hazmatjunk/EquatorialMount/README.md

# EquatorialMount
Musings and designs for telescope mounts

This is just a place to store idears for telescopes
