hazmatjunk/EquatorialMount/Updated Component designs/stepperMount.stl

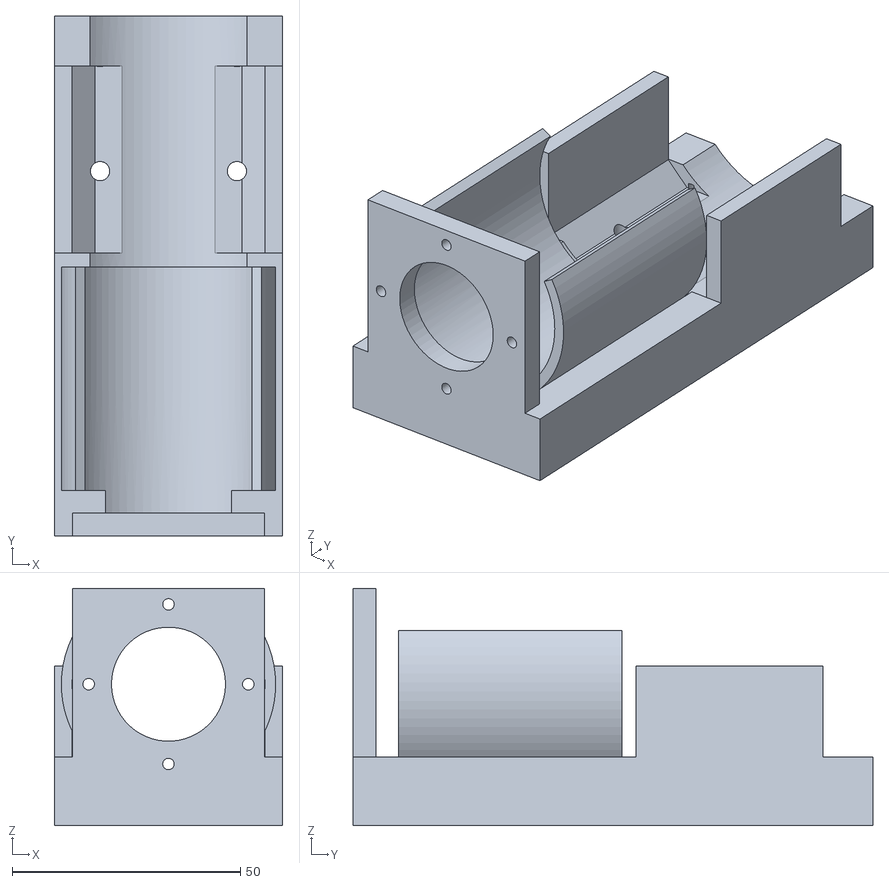
[picture p2: CAD file, 2021-11-07]
Updated Component designs/stepperMount.stl
50.0 x 114.0 x 52.0
