hazmatjunk/EquatorialMount/Updated Component designs/eqMountPreciseparts  assembled v8.png

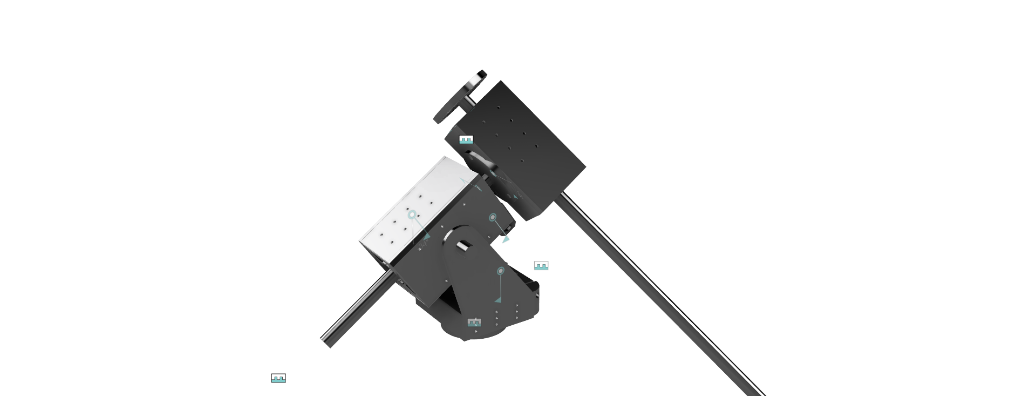
Updated Component designs/eqMountPreciseparts assembled v8.png
