hazmatjunk/EquatorialMount/Updated Component designs/Axel Pin Drawing v1.pdf

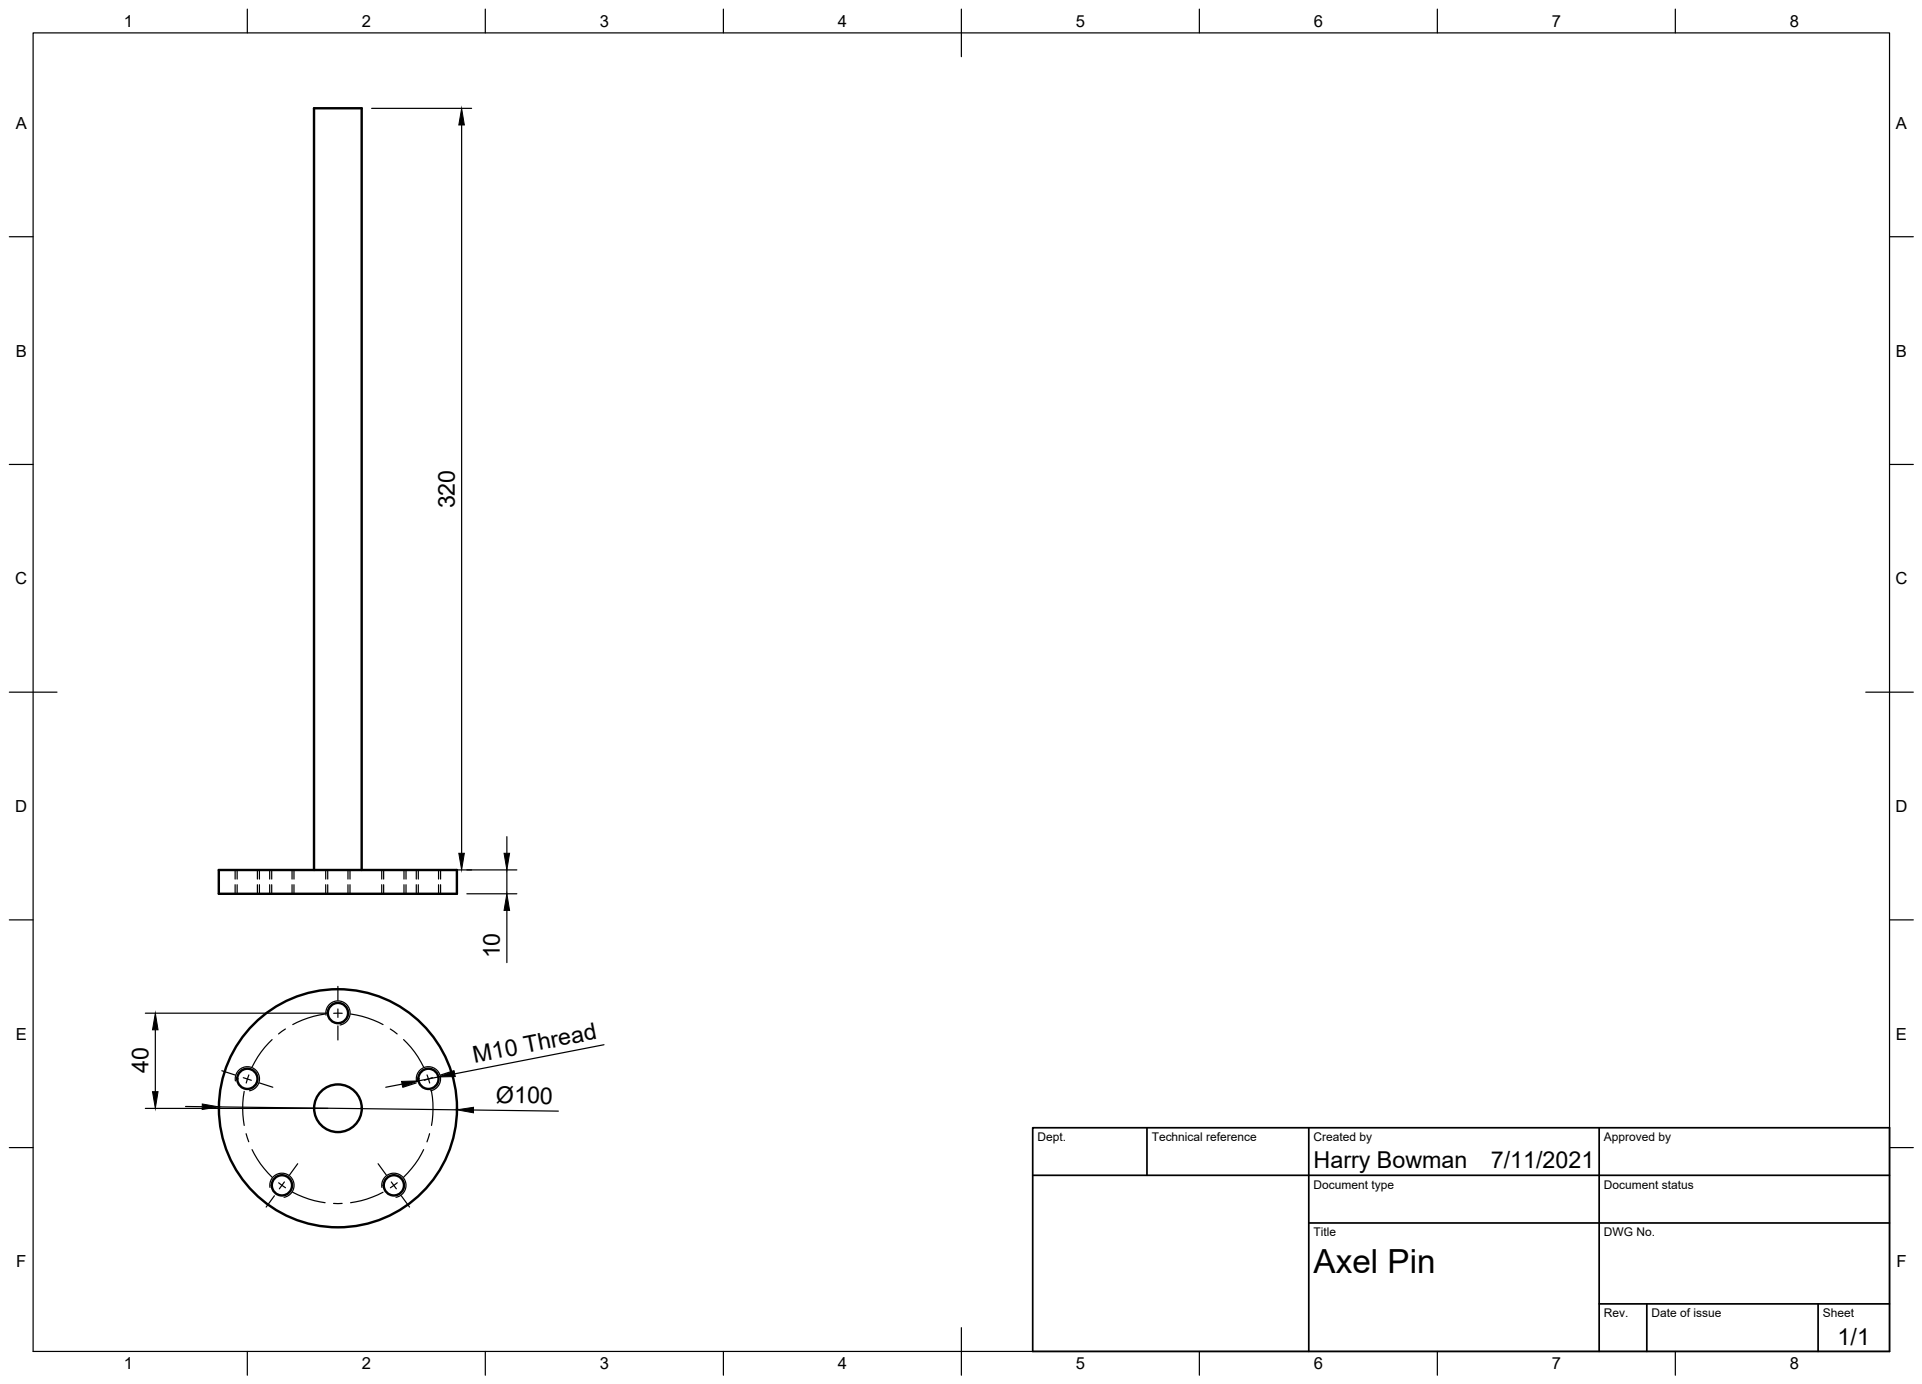
[picture p4: page 1]
Title; DWG No.; Rev.; Date of issue; Sheet; Axel Pin; Harry Bowman 320; M10 Thread

Dept. | Technical reference | Created by 7/11/2021 | Approved by

Document type | Document status
