hazmatjunk/EquatorialMount/Updated Component designs/base housing Plate Drawing v1.pdf

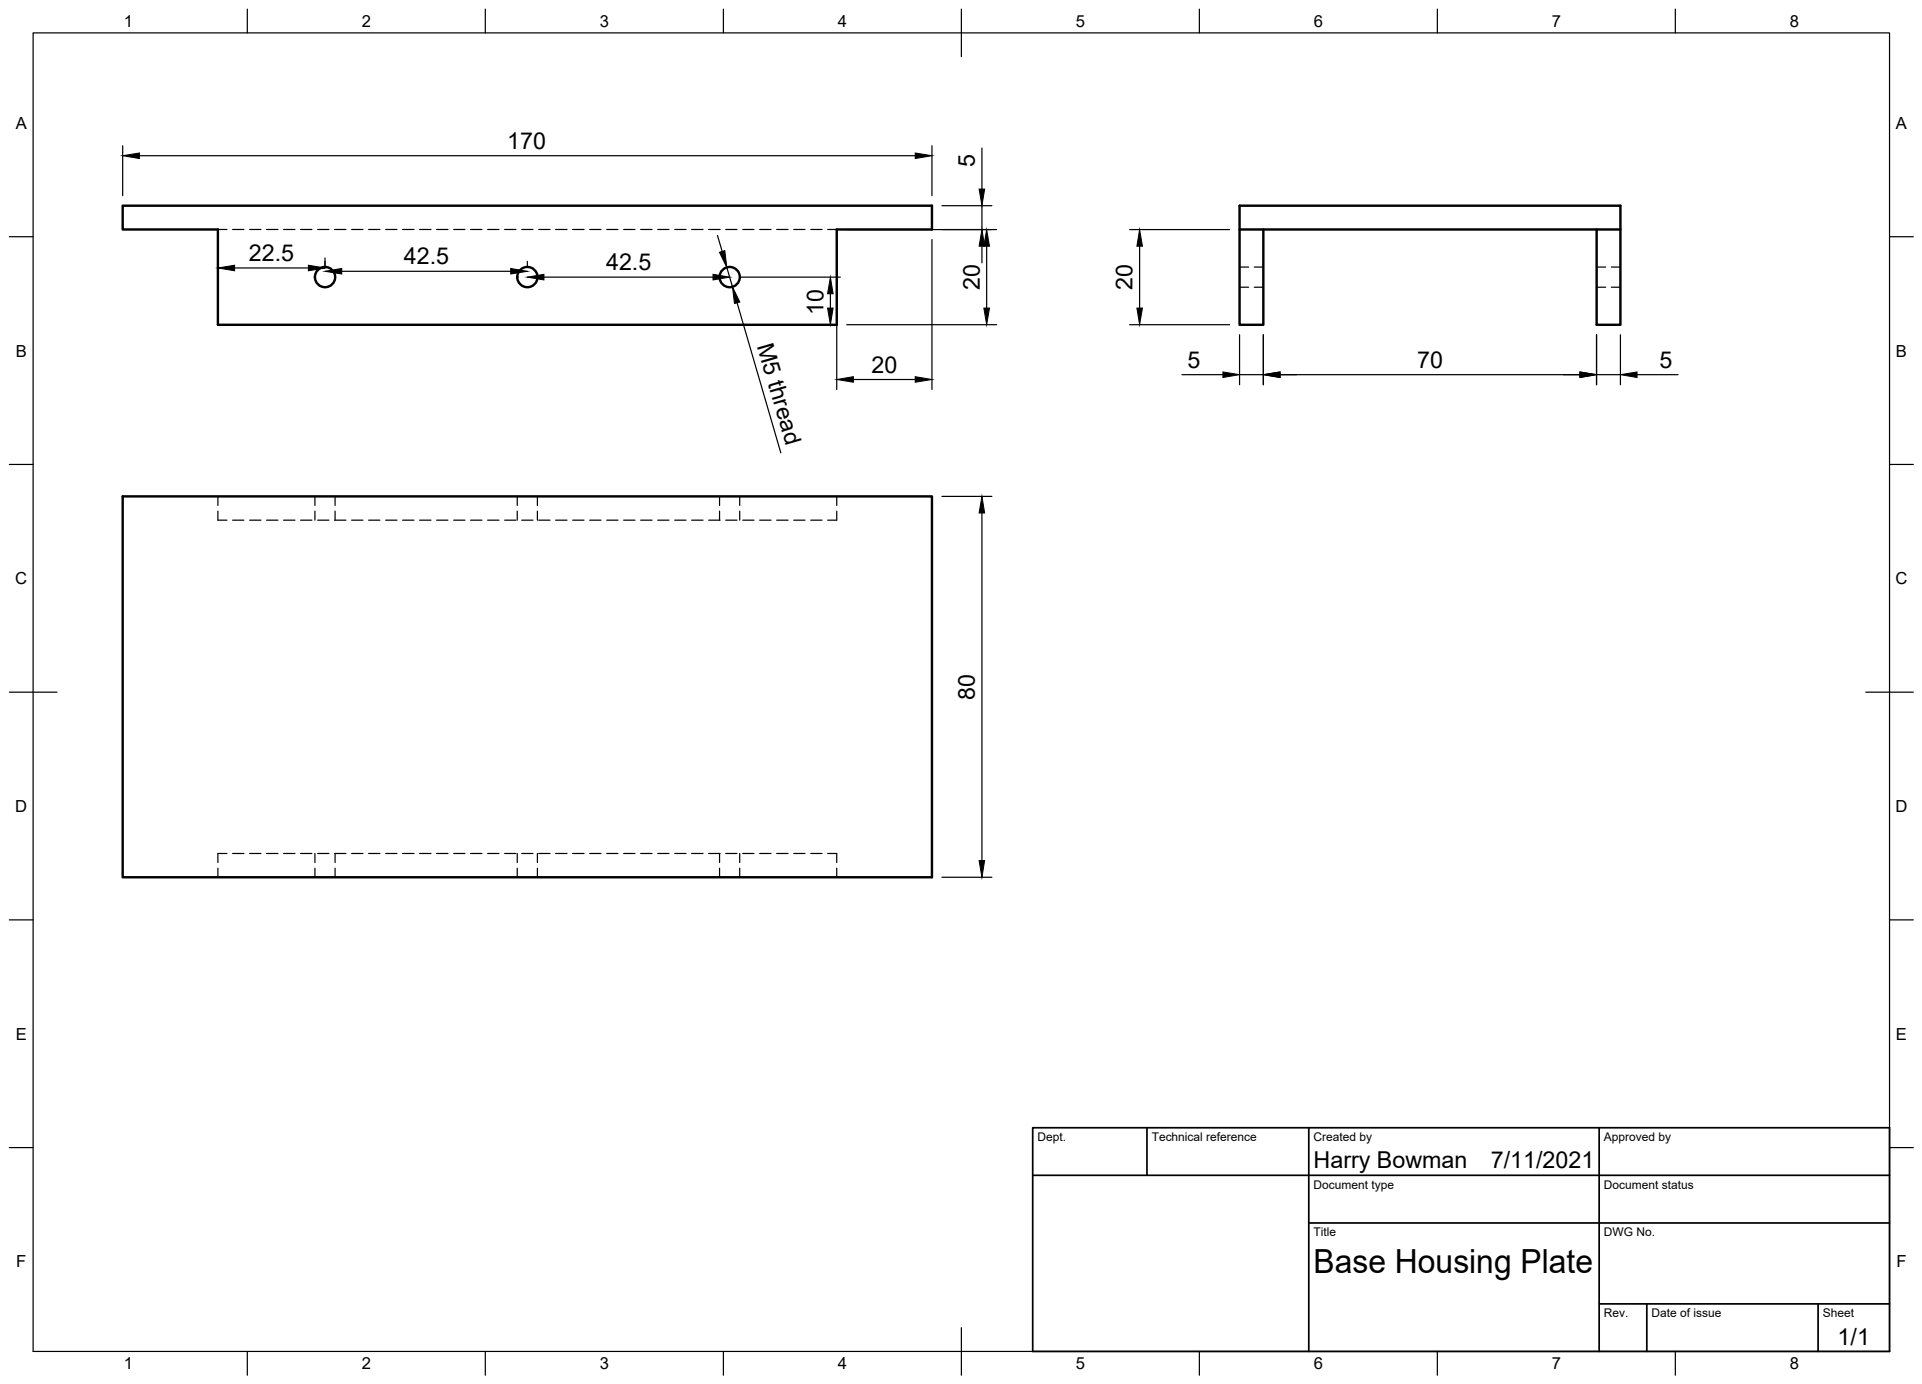
[picture p5: page 1]
Title; DWG No.; Rev.; Date of issue; Sheet; M5 thread

Dept. | Technical reference | Created by Harry Bowman 7/11/2021 | Approved by

Document type | Document status

Base Housing Plate
