hazmatjunk/EquatorialMount/Updated Component designs/basePlate Drawing v2.pdf

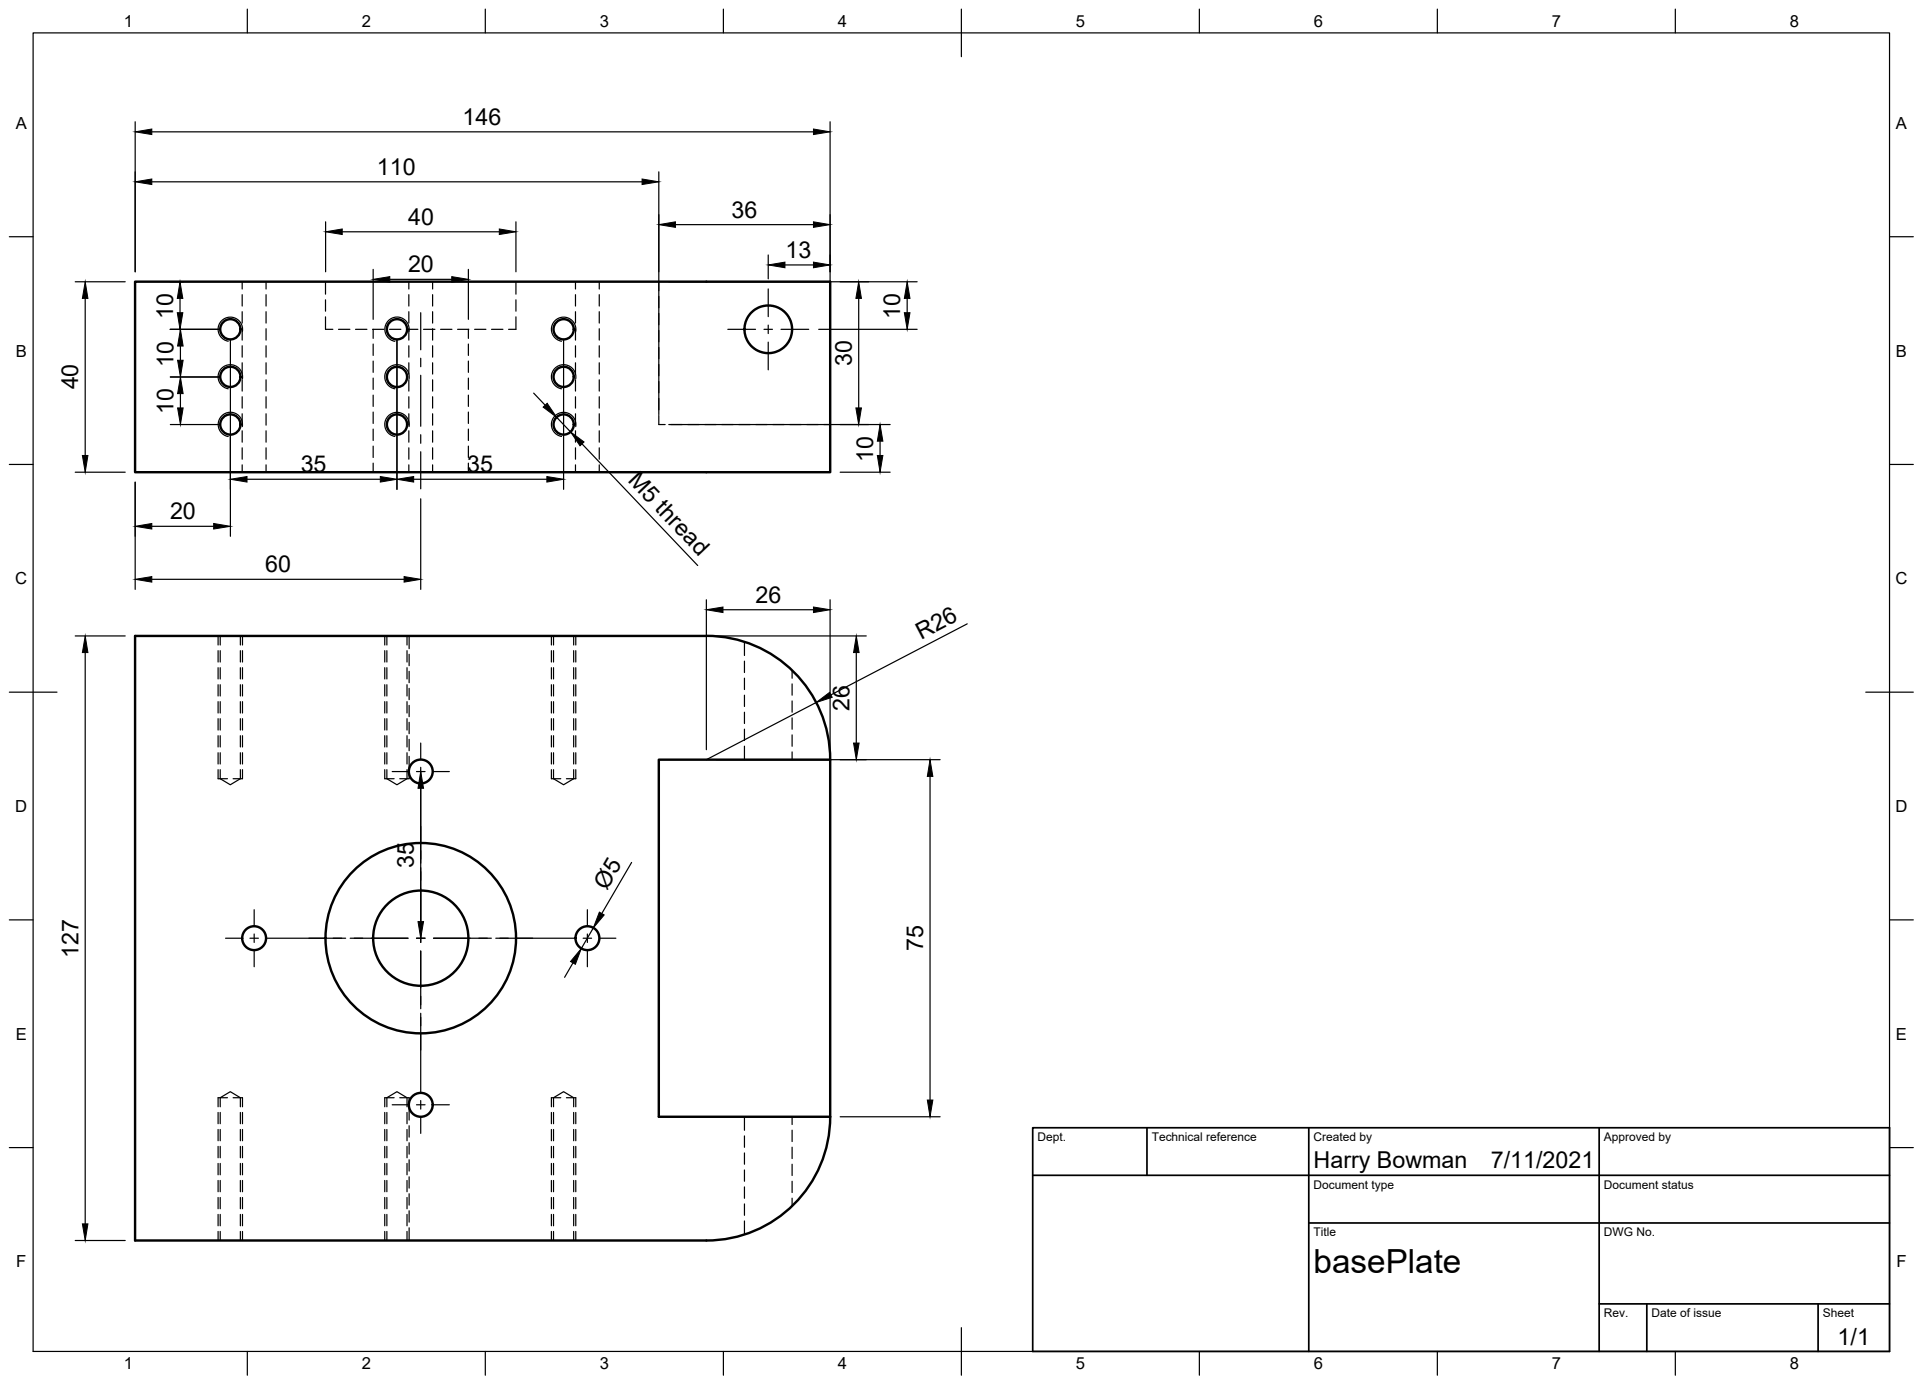
[picture p6: page 1]
Title; DWG No.; Rev.; Date of issue; Sheet; Harry Bowman 40; M5 thread

Dept. | Technical reference | Created by 7/11/2021 | Approved by

Document type | Document status
