hazmatjunk/EquatorialMount/Updated Component designs/Dec Pin Plate Drawing v2.pdf

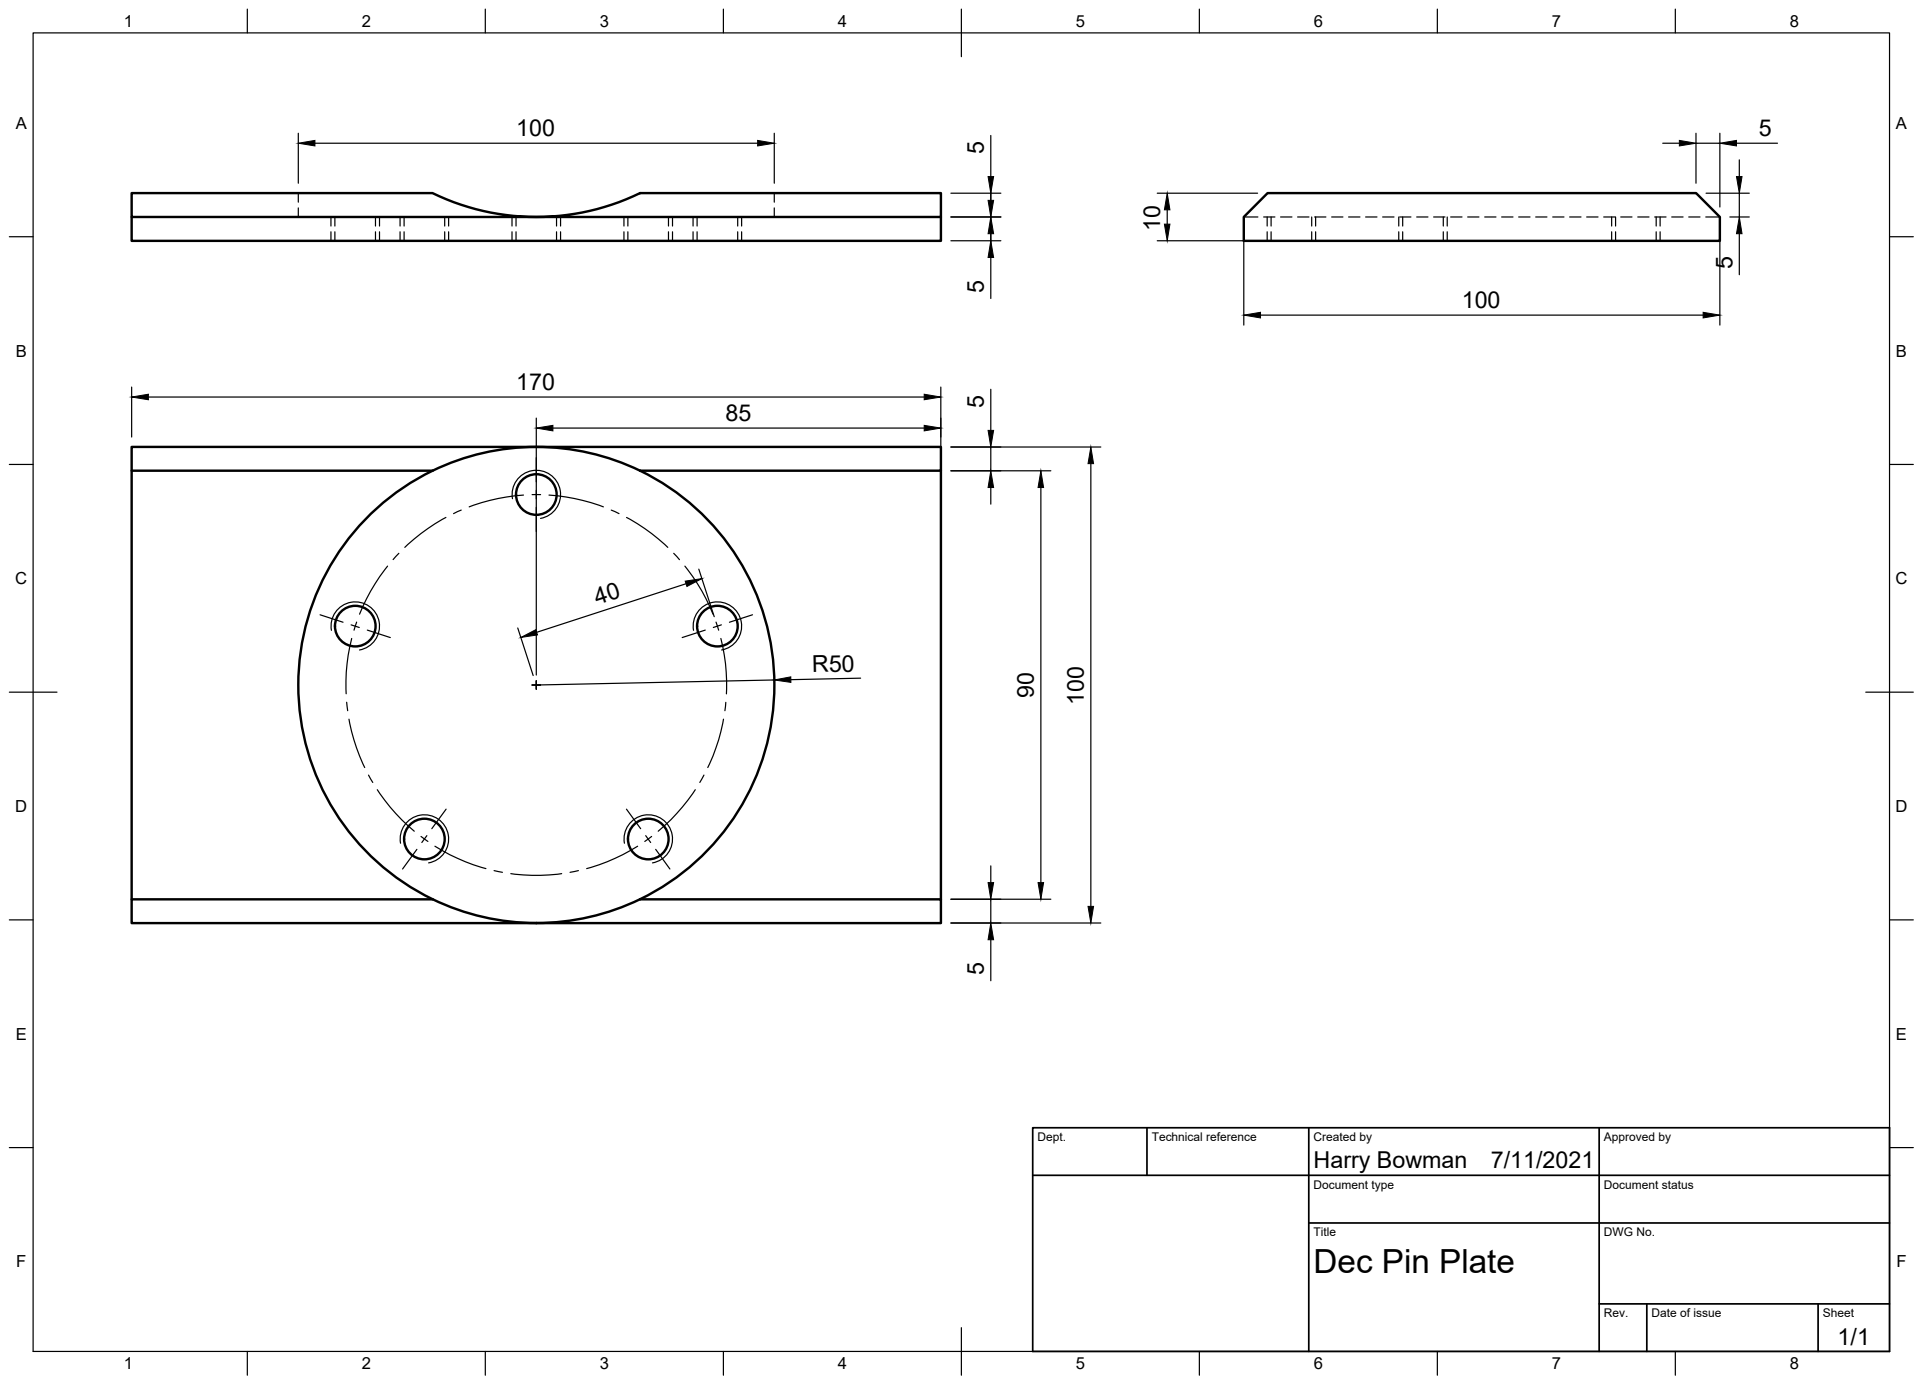
[picture p7: page 1]
Title; DWG No.; Rev.; Date of issue; Sheet

Dept. | Technical reference | Created by Harry Bowman 7/11/2021 | Approved by

Document type | Document status

Dec Pin Plate
