hazmatjunk/EquatorialMount/Updated Component designs/End Plates Drawings v1.pdf

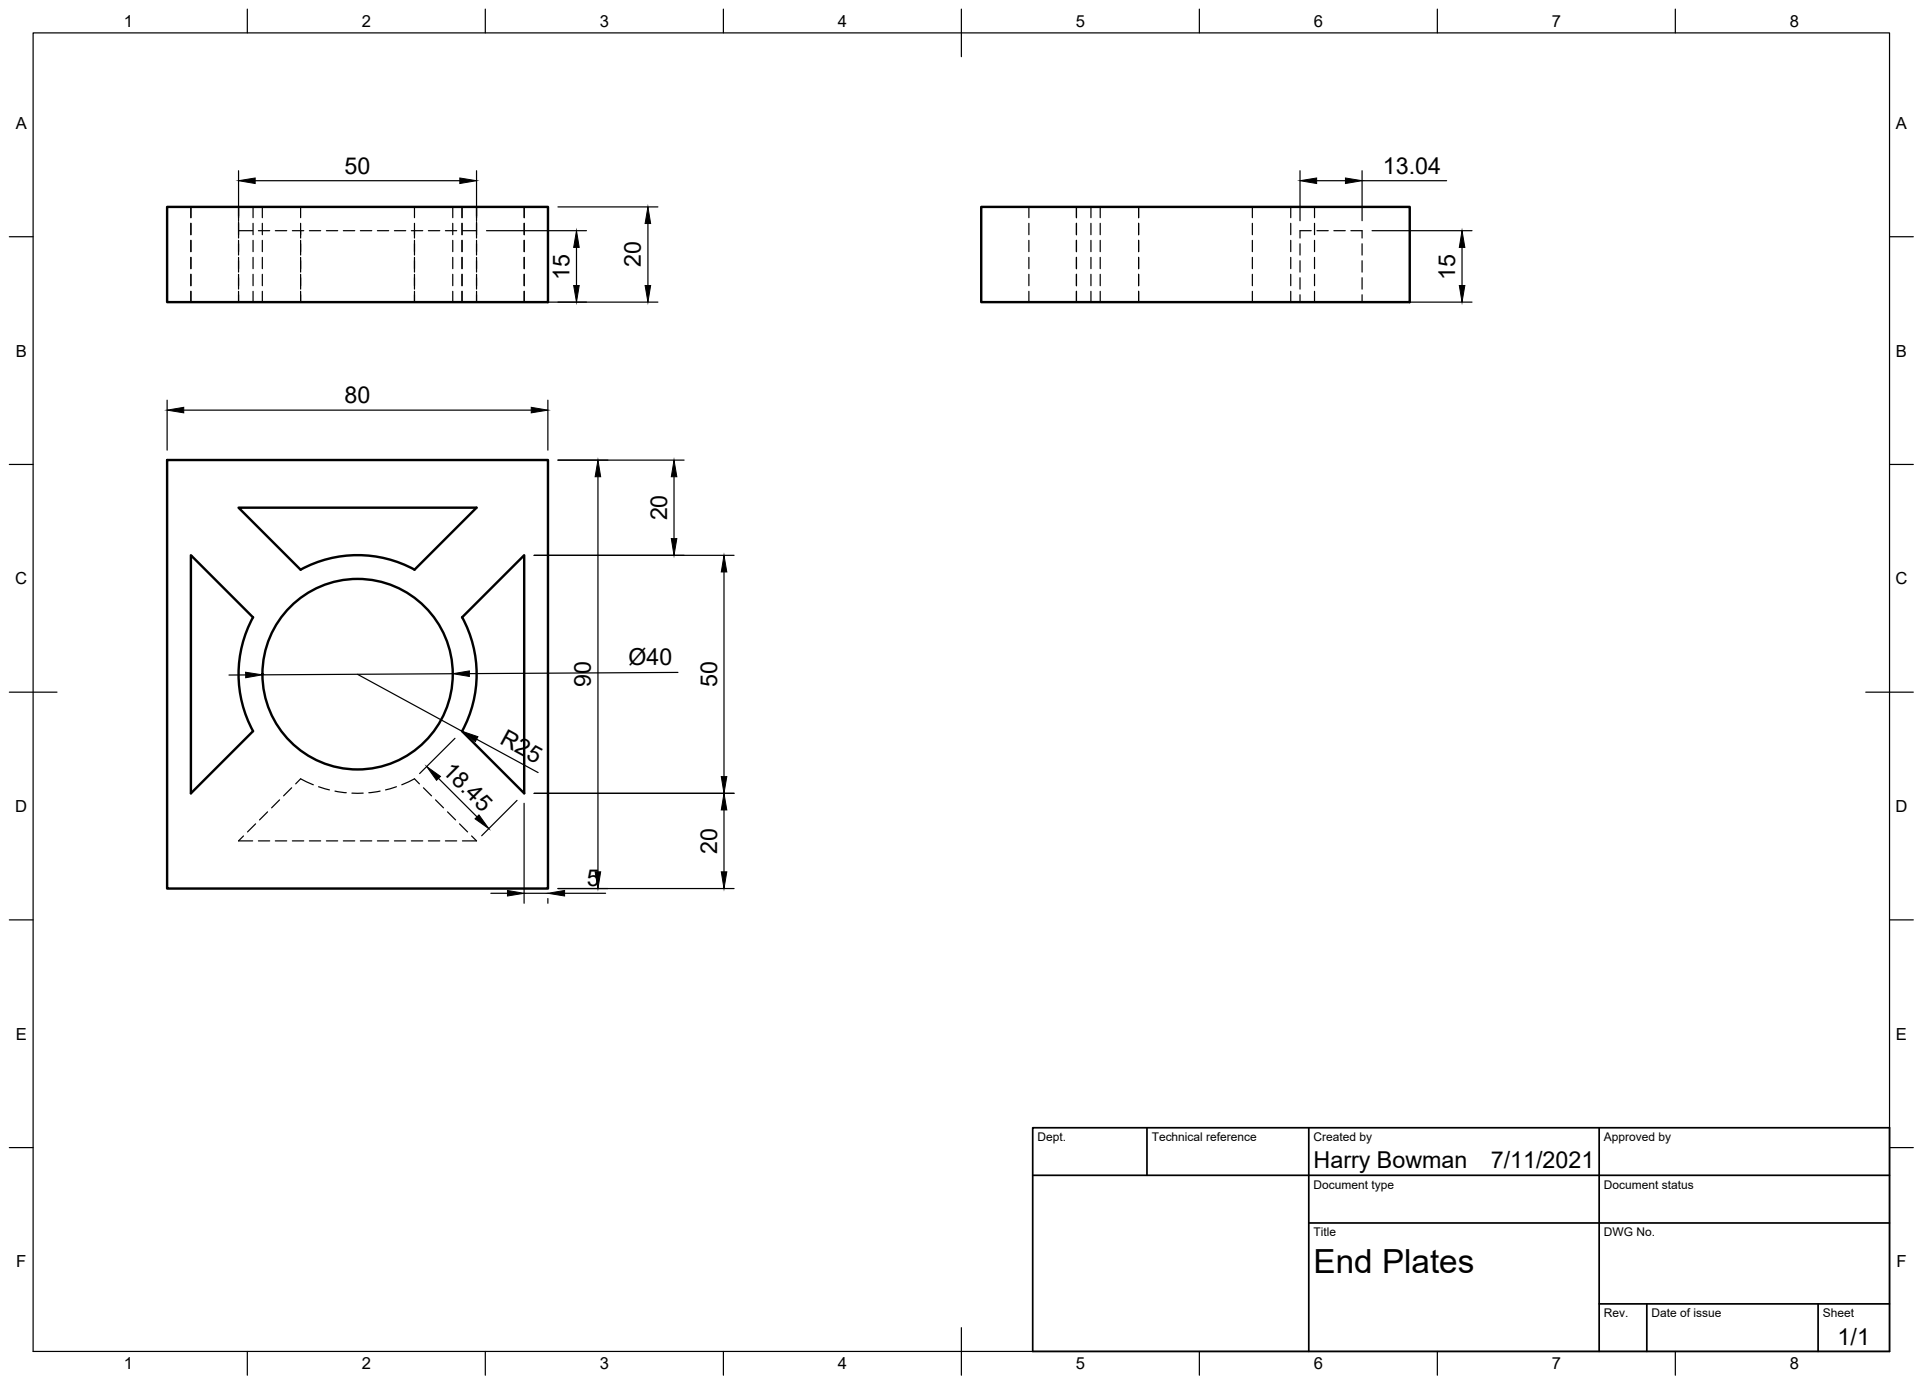
[picture p8: page 1]
Title; DWG No.; Rev.; Date of issue; Sheet; End Plates

Dept. | Technical reference | Created by Harry Bowman 7/11/2021 | Approved by

Document type | Document status
