hazmatjunk/EquatorialMount/Updated Component designs/RA Clapm Drawing v1.pdf

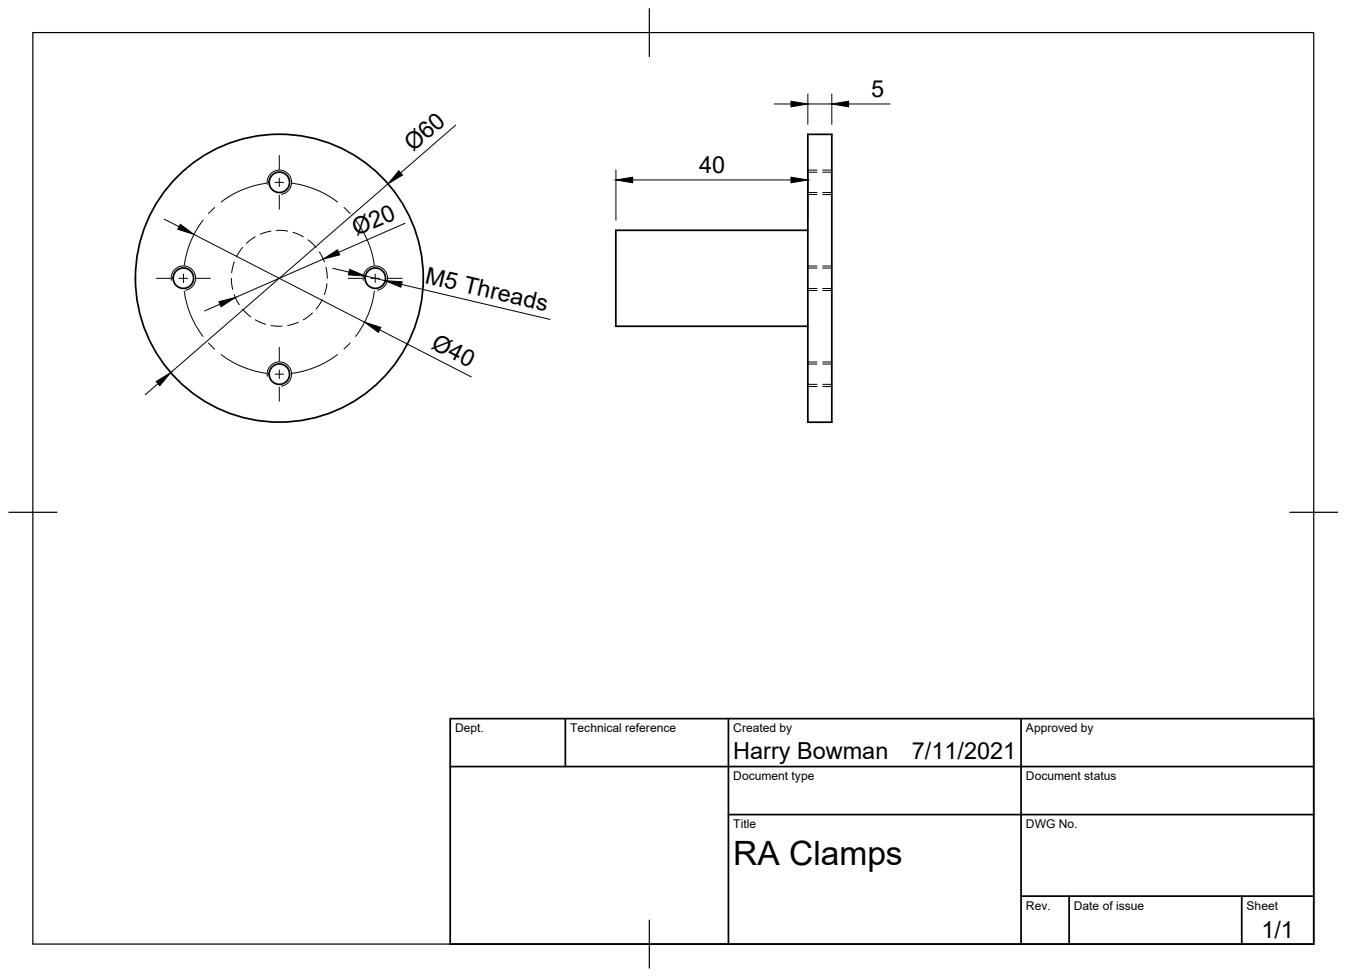
[picture p9: page 1]
M5 Threads

Dept. | Technical reference | Created by Harry Bowman 7/11/2021 | Approved by

Document type | Document status

Title RA Clamps | DWG No.

Rev. | Date of issue | Sheet 1/1
