hazmatjunk/EquatorialMount/Updated Component designs/Side Plate v2.pdf

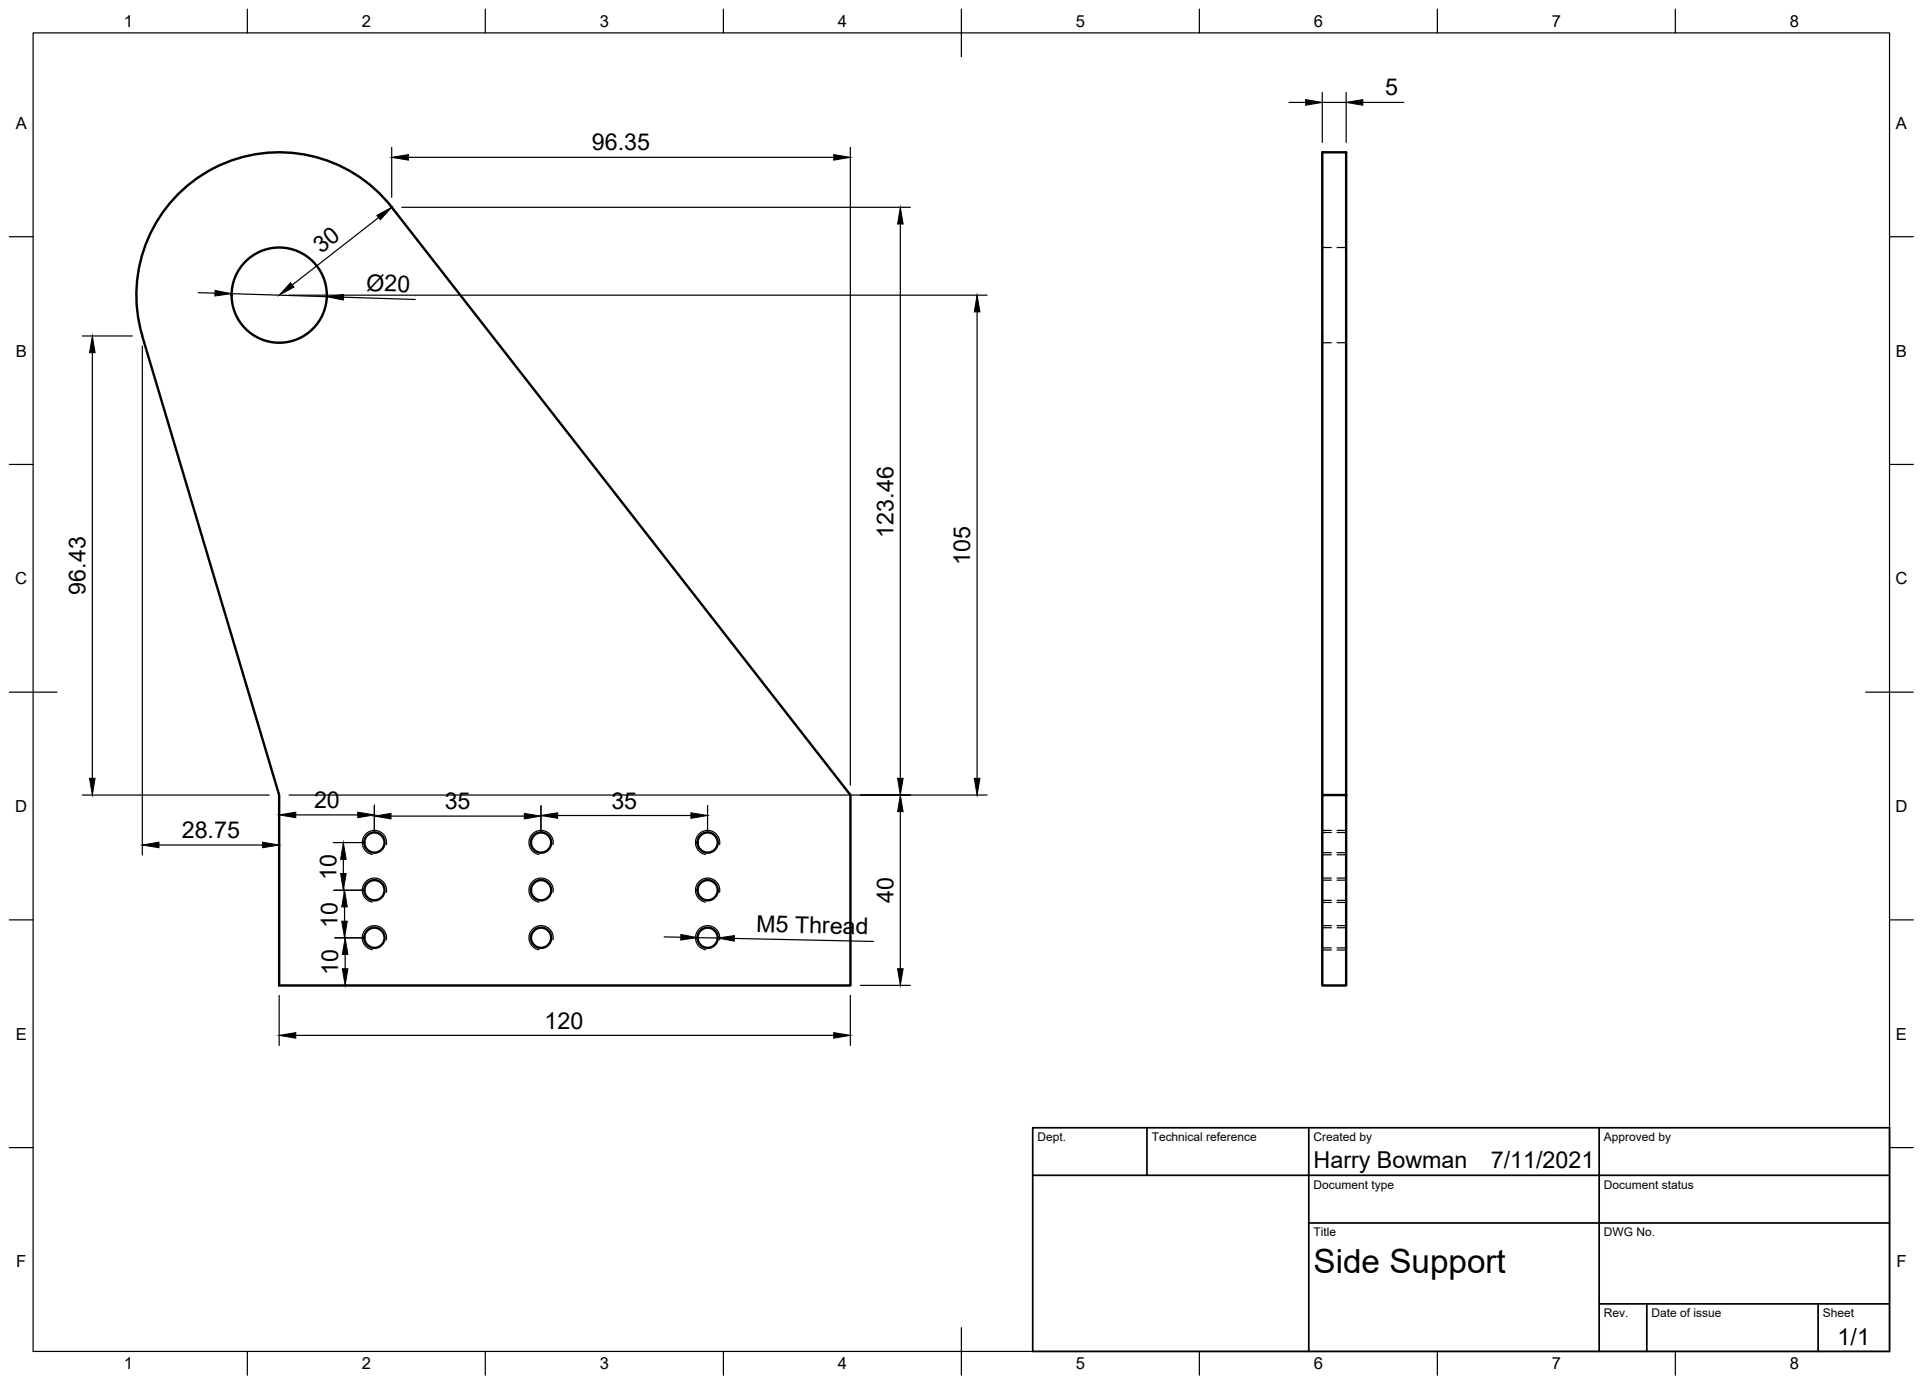
[picture p10: page 1]
Title; DWG No.; Rev.; Date of issue; Sheet; Side Support; M5 Thread 105

Dept. | Technical reference | Created by Harry Bowman 7/11/2021 | Approved by

Document type | Document status
