hazmatjunk/EquatorialMount/Updated Component designs/Top ALt Support Drawing v1.pdf

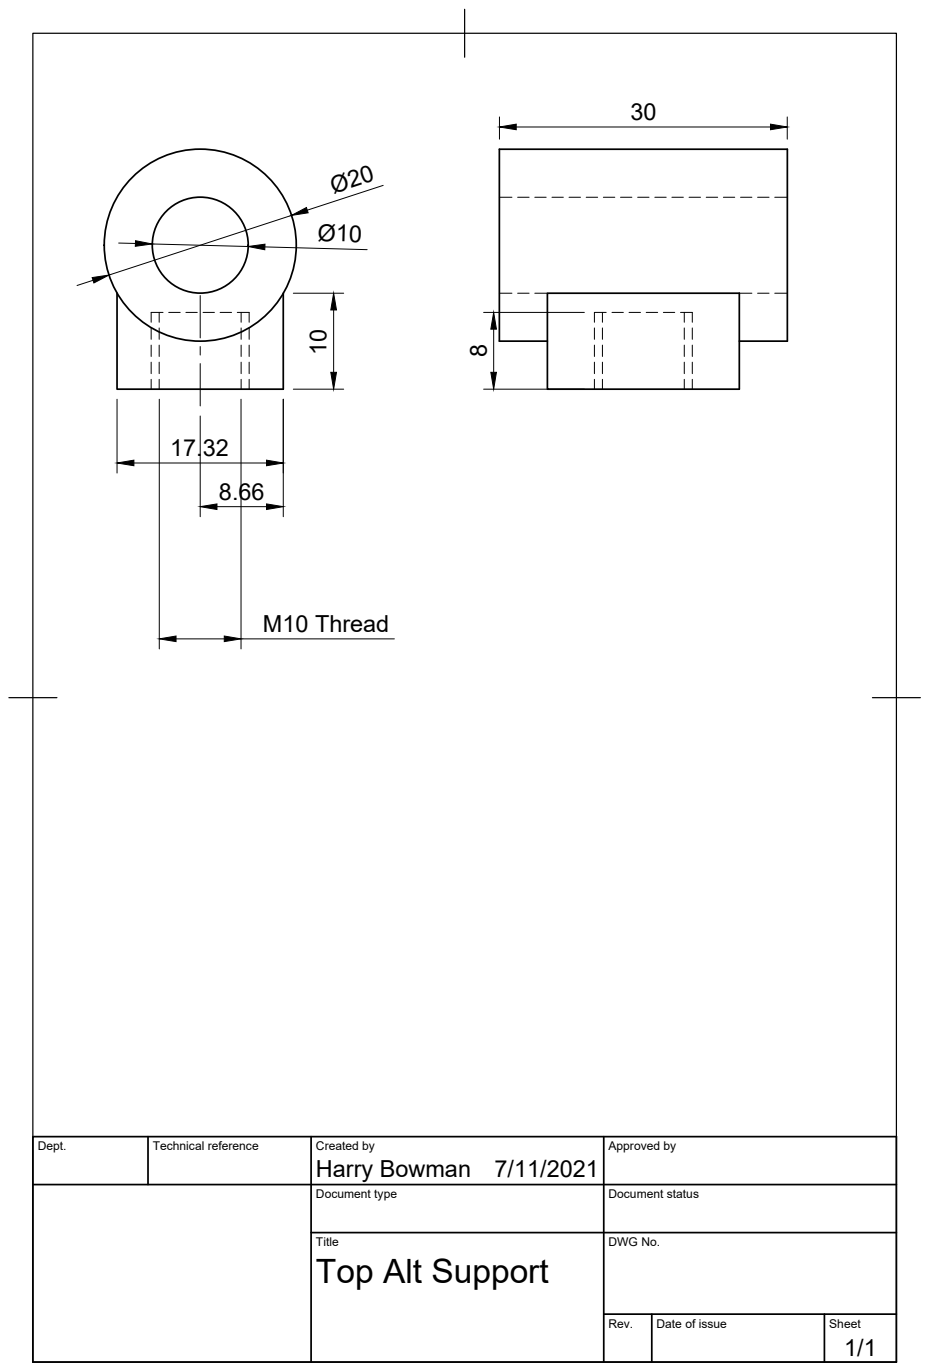
[picture p11: page 1]
M10 Thread

Dept. | Technical reference | Created by Harry Bowman 7/11/2021 | Approved by

Document type | Document status

Title Top Alt Support | DWG No.

Rev. | Date of issue | Sheet 1/1
