hazmatjunk/EquatorialMount/OnstepCadV0.1/eqatorialmount_fullassemblydrawing v1.pdf

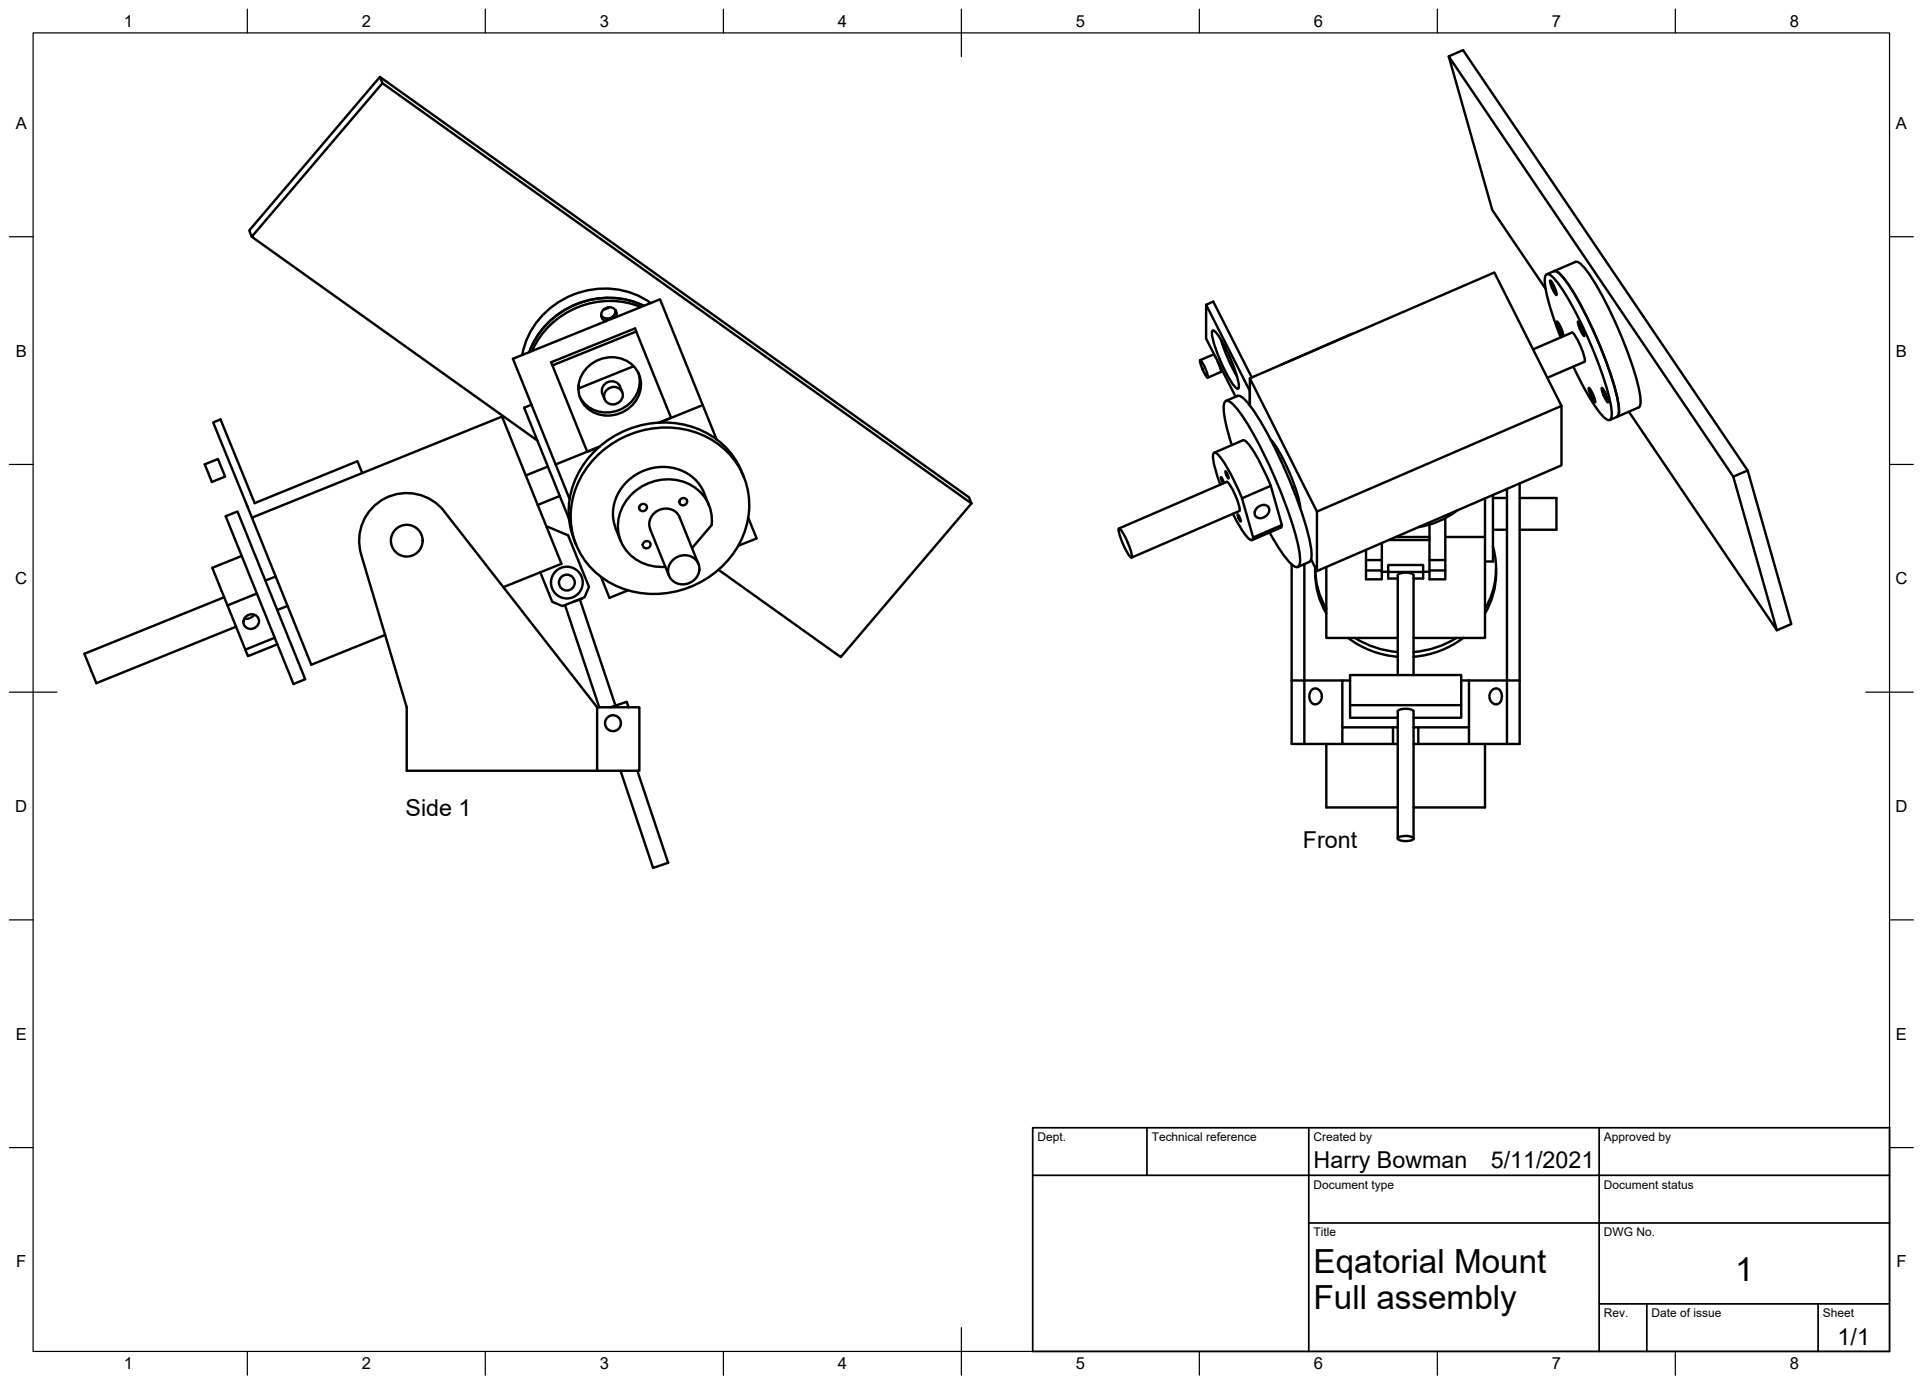
[picture p12: page 1]
Title; DWG No.; Rev.; Date of issue; Sheet; Full assembly; Eqatorial Mount; Side 1

Dept. | Technical reference | Created by Harry Bowman 5/11/2021 | Approved by

Document type | Document status
