hazmatjunk/EquatorialMount/OnstepCadV0.1/eqatorialmount_PartSchematicv4.pdf

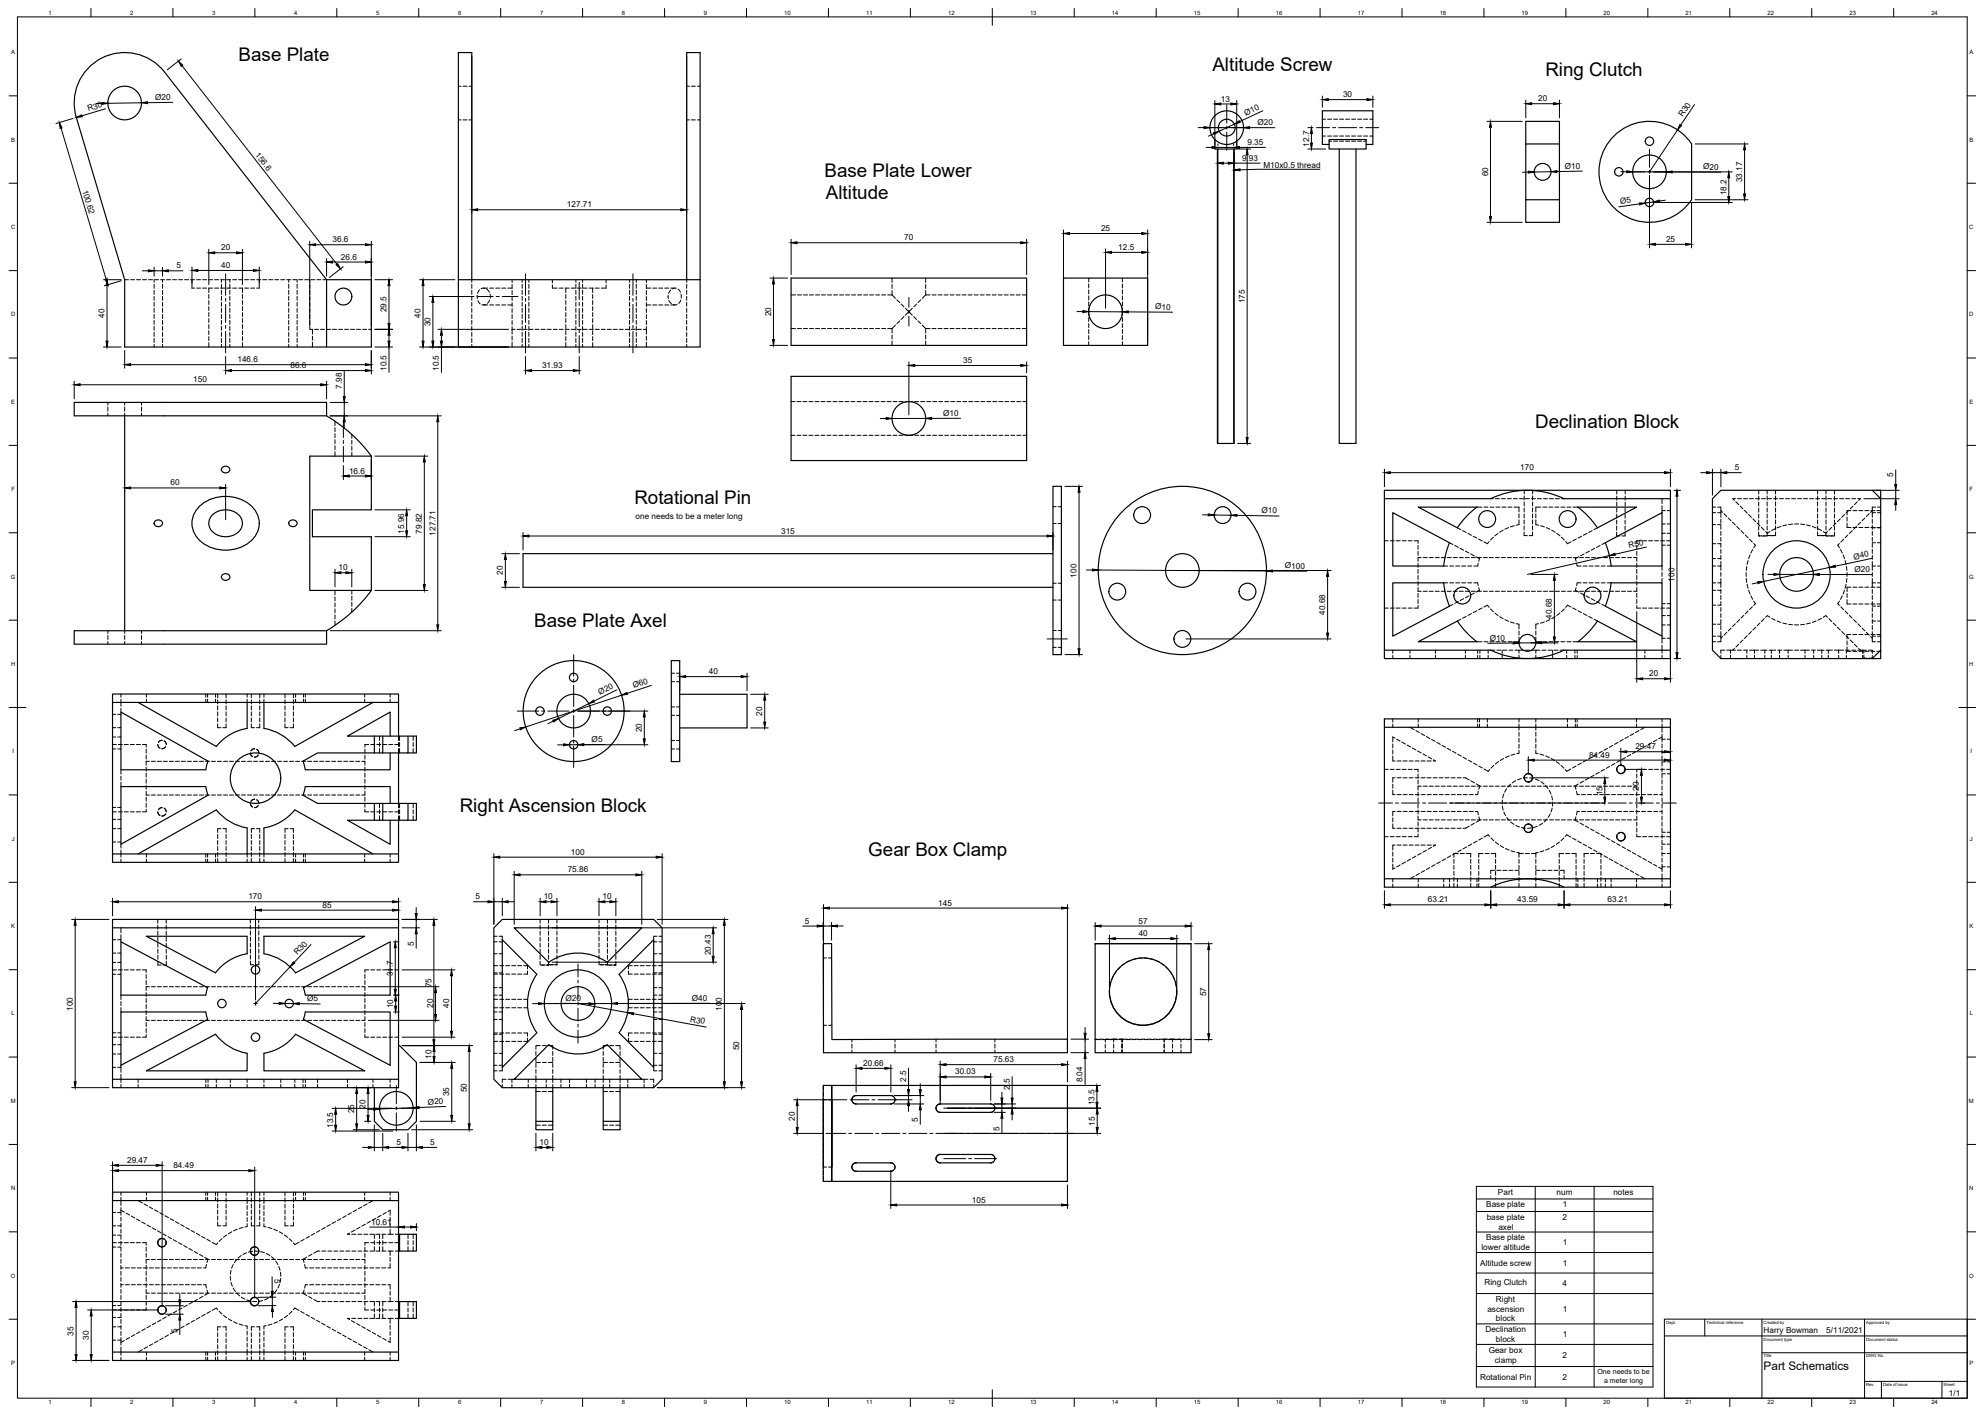
[picture p13: page 1]
24 BADCFEHGIKJMLONP; BADCFEHGIKJMLONP Dept.; Technical reference; Created by; Approved by Document type; Document status Title; DWG No. Rev.; Date of issue; Sheet 5/11/2021; 1/1 Part Schematics Harry Bowman; 12.7 9.93 M10x0.5 thread 170

20 29.47 Ø20 Ø40 20 5 Rotational Pin 2 One needs to be a meter long Gear box clamp 2 Declination block 1 Right ascension block 1 Ring Clutch 4 Altitude screw 1 Base plate lower altitude 1 base plate axel 2 Base plate 1 Part num notes Gear Box Clamp Right Ascension Block Declination Block Rotational Pin one needs to be a meter long Ring Clutch Base Plate Axel Base Plate 86.6 31.93 Base Plate Lower Altitude Altitude Screw
