hazmatjunk/EquatorialMount/Updated Component designs/Alt attch Drawing v1.pdf

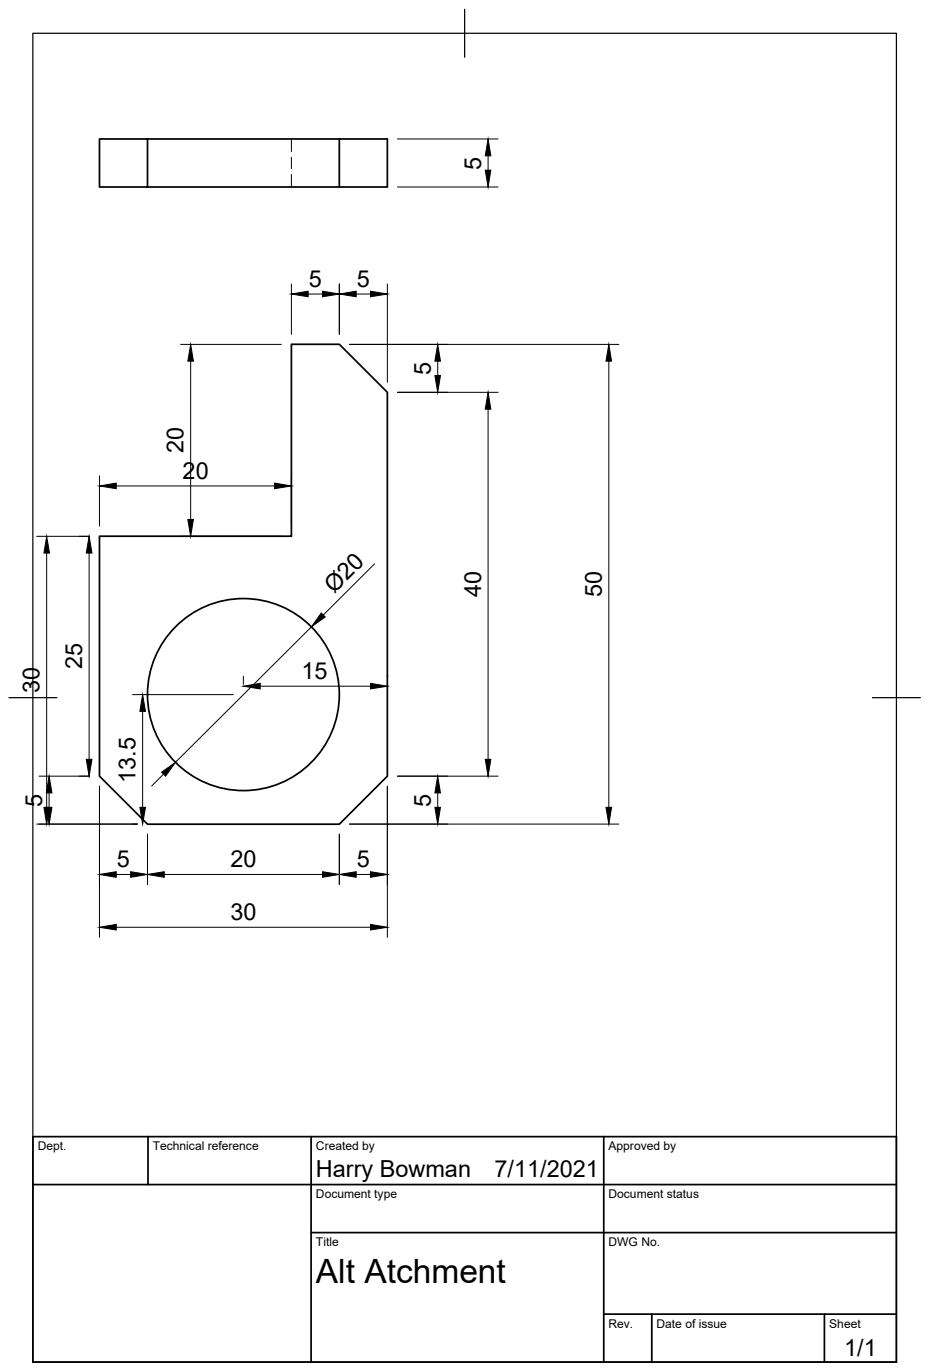
[picture p14: page 1]

Dept. | Technical reference | Created by Harry Bowman 7/11/2021 | Approved by

Document type | Document status

Title Alt Atchment | DWG No.

Rev. | Date of issue | Sheet 1/1
