hazmatjunk/EquatorialMount/Updated Component designs/Bottom Alt Support Drawing v1.pdf

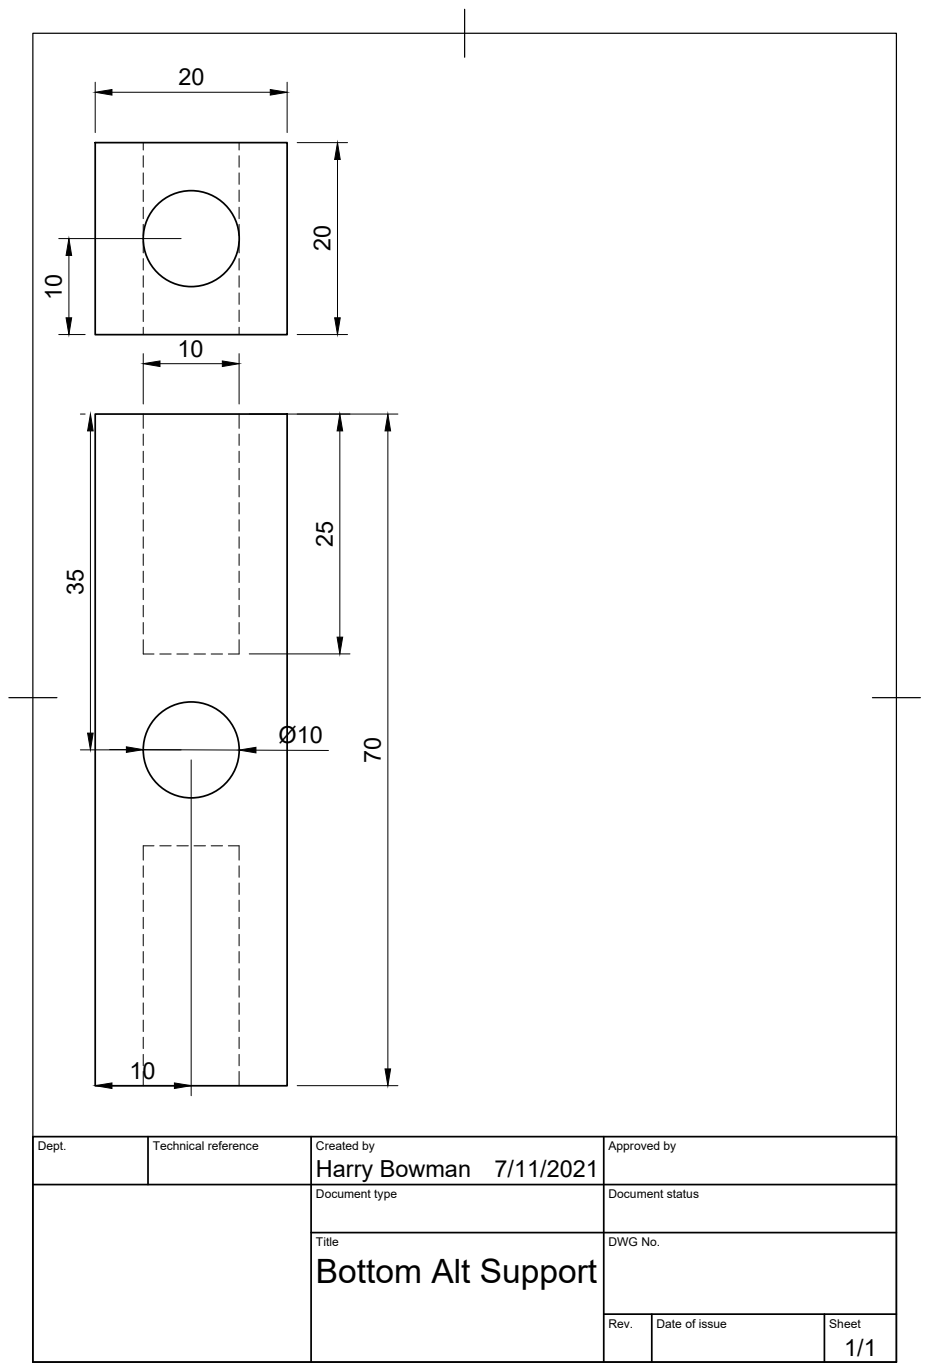
[picture p15: page 1]

Dept. | Technical reference | Created by Harry Bowman 7/11/2021 | Approved by

Document type | Document status

Title Bottom Alt Support | DWG No.

Rev. | Date of issue | Sheet 1/1
