hazmatjunk/EquatorialMount/OnstepCadV0.1/OnstepContollerSchematic.pdf

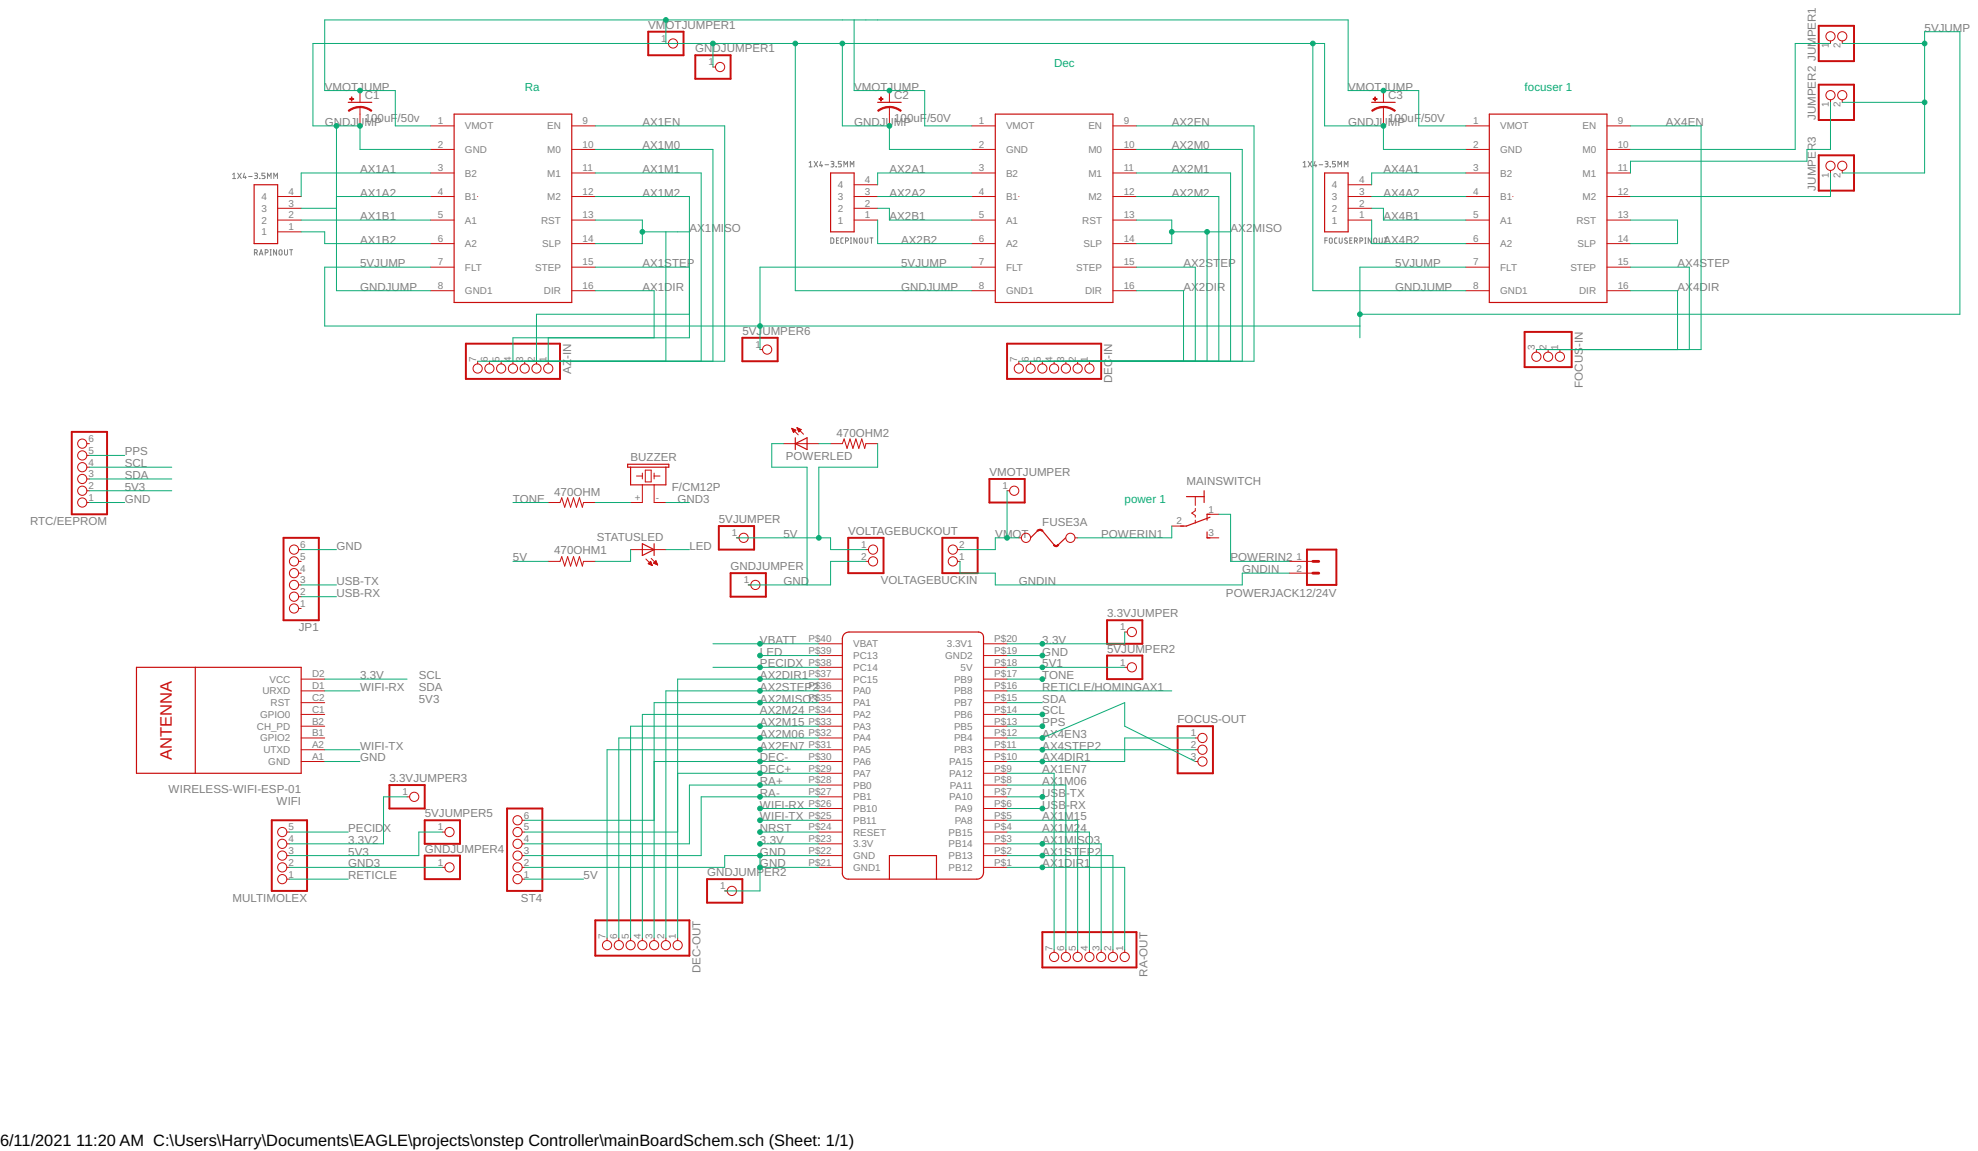
[picture p16: page 1]

6/11/2021 11:20 AM C:\Users\Harry\Documents\EAGLE\projects\onstep Controller\mainBoardSchem.sch (Sheet: 1/1)
