hazmatjunk/EquatorialMount/OnstepCadV0.1/OnstepPCBlayout.pdf

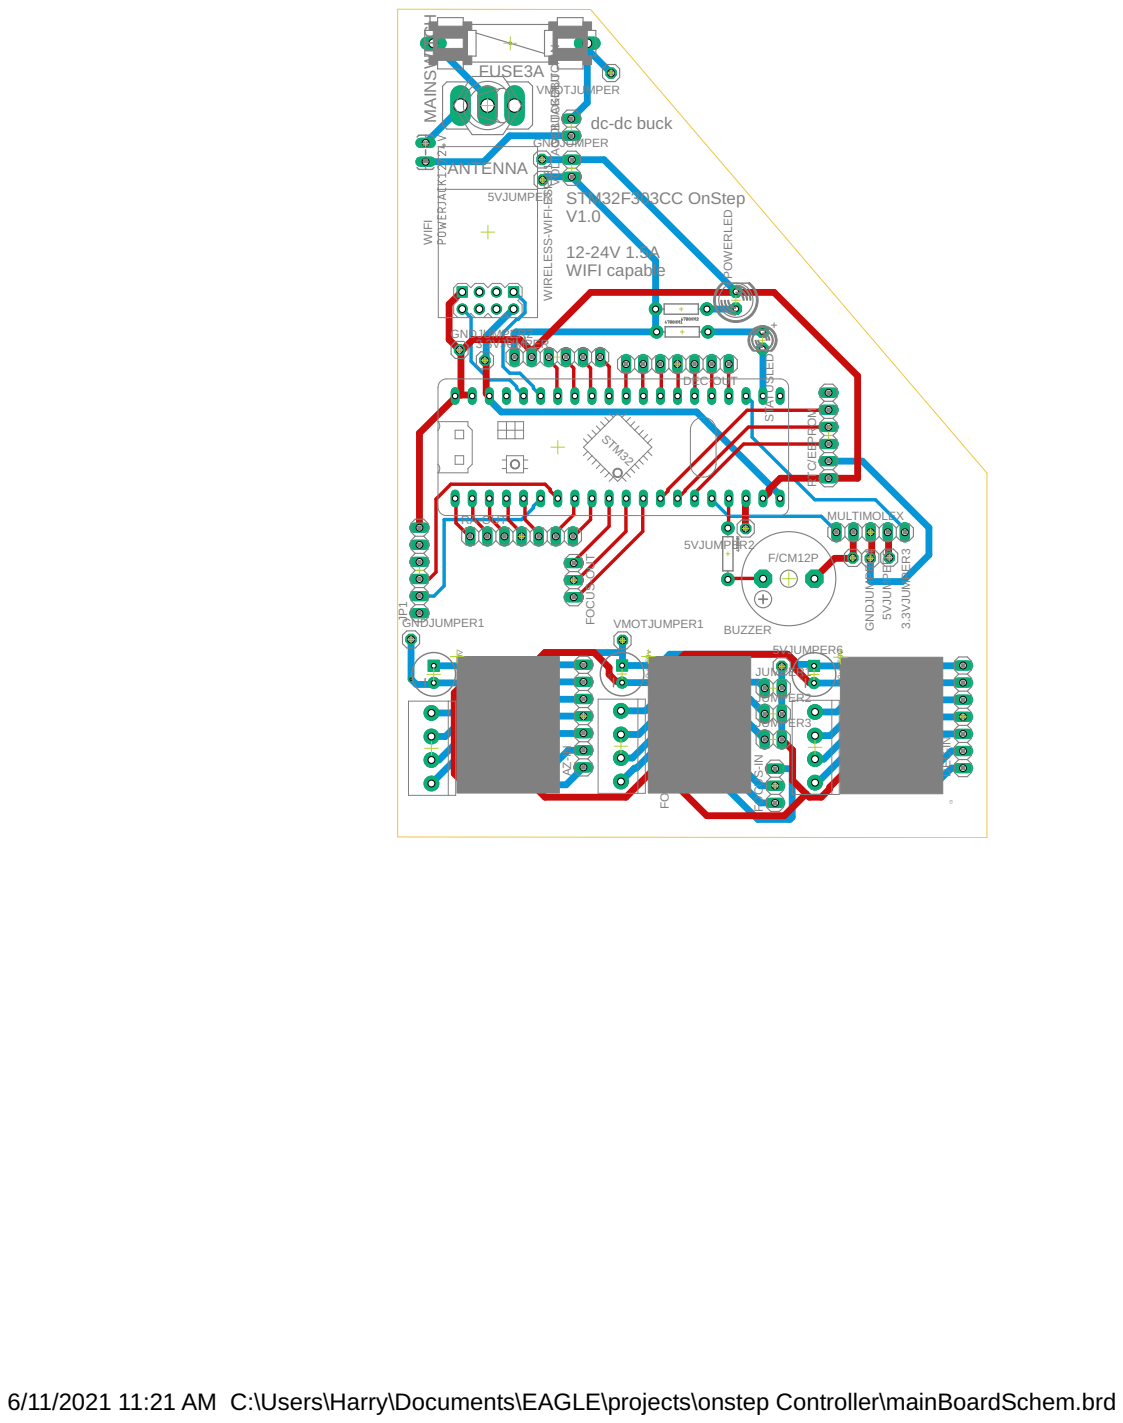
[picture p17: page 1]

6/11/2021 11:21 AM C:\Users\Harry\Documents\EAGLE\projects\onstep Controller\mainBoardSchem.brd
